Burlinlove/shoggoth-mini/assets/synthetic/objects/1.png

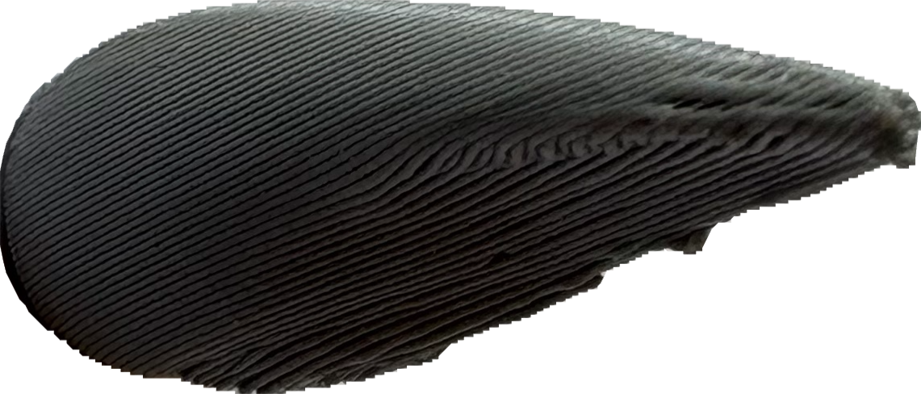
assets/synthetic/objects/1.png
