Burlinlove/shoggoth-mini/assets/synthetic/objects/2.png

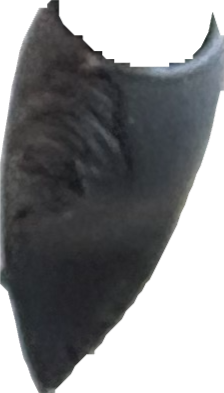
assets/synthetic/objects/2.png
