Burlinlove/shoggoth-mini/assets/synthetic/objects/3.png

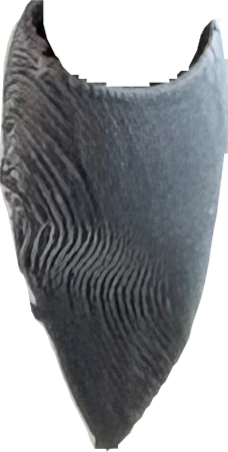
assets/synthetic/objects/3.png
