Burlinlove/shoggoth-mini/assets/synthetic/objects/4.png

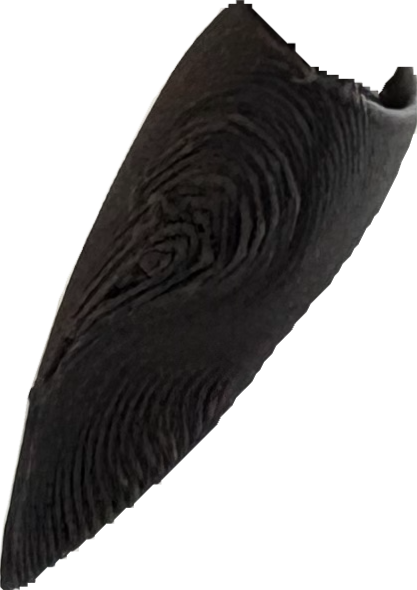
assets/synthetic/objects/4.png
