Burlinlove/shoggoth-mini/assets/synthetic/objects/5.png

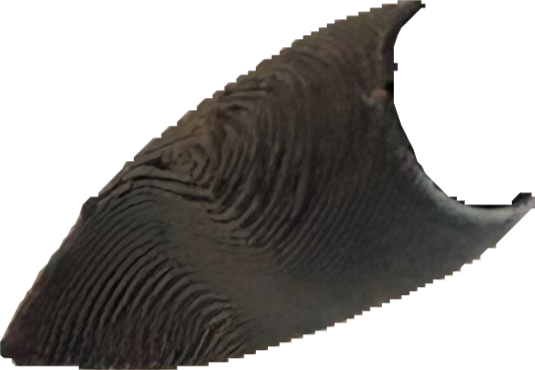
assets/synthetic/objects/5.png
