Burlinlove/shoggoth-mini/assets/synthetic/objects/6.png

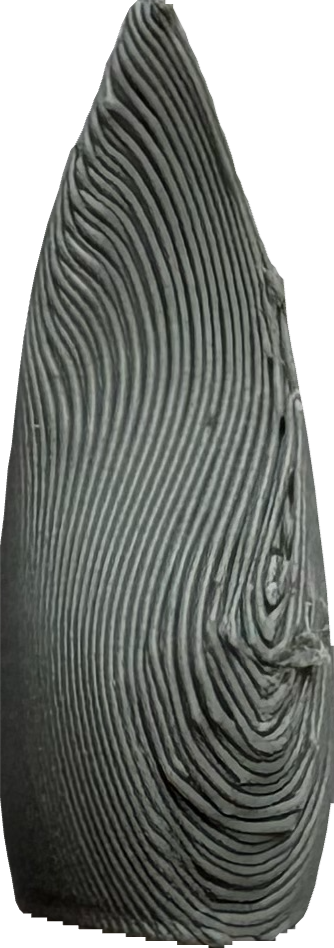
assets/synthetic/objects/6.png
