Burlinlove/shoggoth-mini/assets/synthetic/objects/7.png

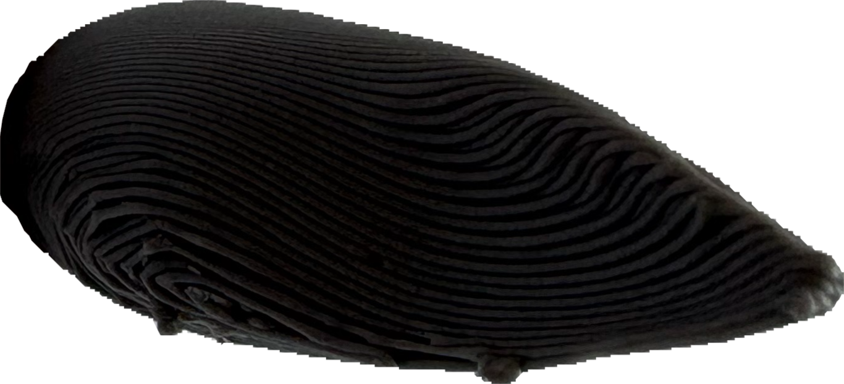
assets/synthetic/objects/7.png
