Burlinlove/shoggoth-mini/assets/synthetic/objects/8.png

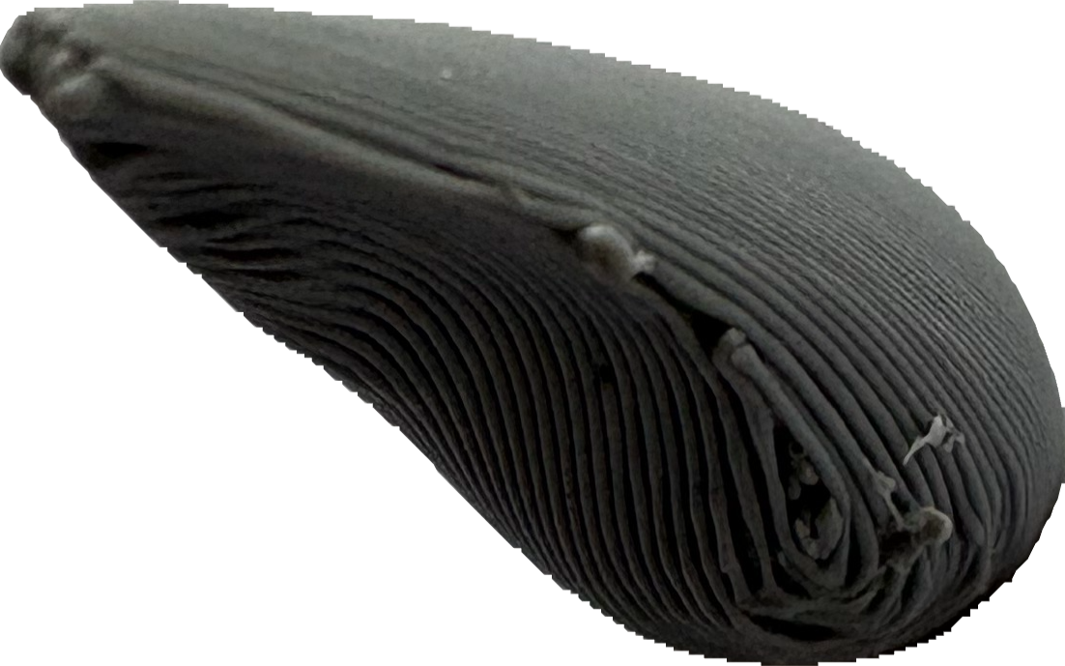
assets/synthetic/objects/8.png
