Burlinlove/shoggoth-mini/assets/synthetic/objects/9.png

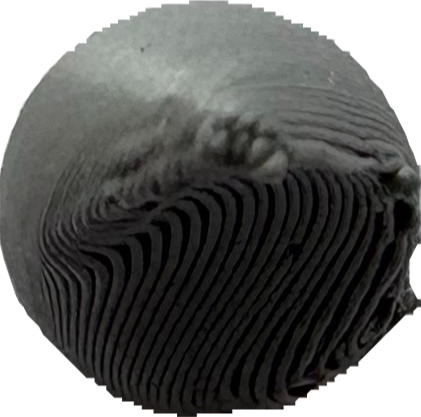
assets/synthetic/objects/9.png
