Burlinlove/shoggoth-mini/assets/synthetic/objects/10.png

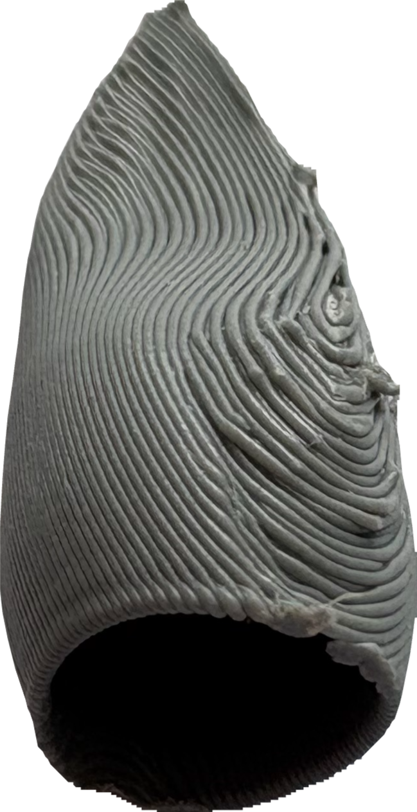
assets/synthetic/objects/10.png
