Burlinlove/shoggoth-mini/assets/synthetic/objects/11.png

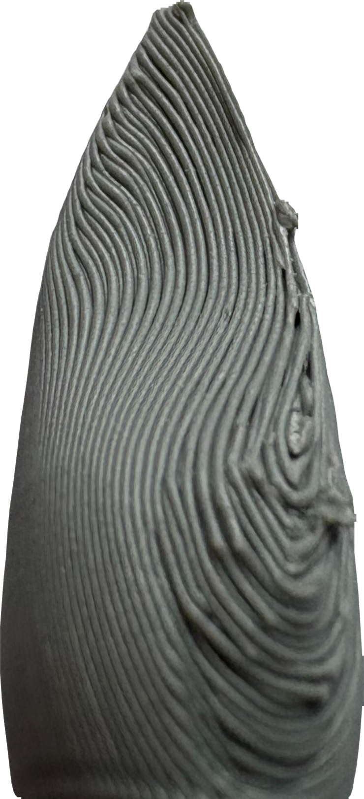
assets/synthetic/objects/11.png
