Burlinlove/shoggoth-mini/assets/synthetic/objects/12.png

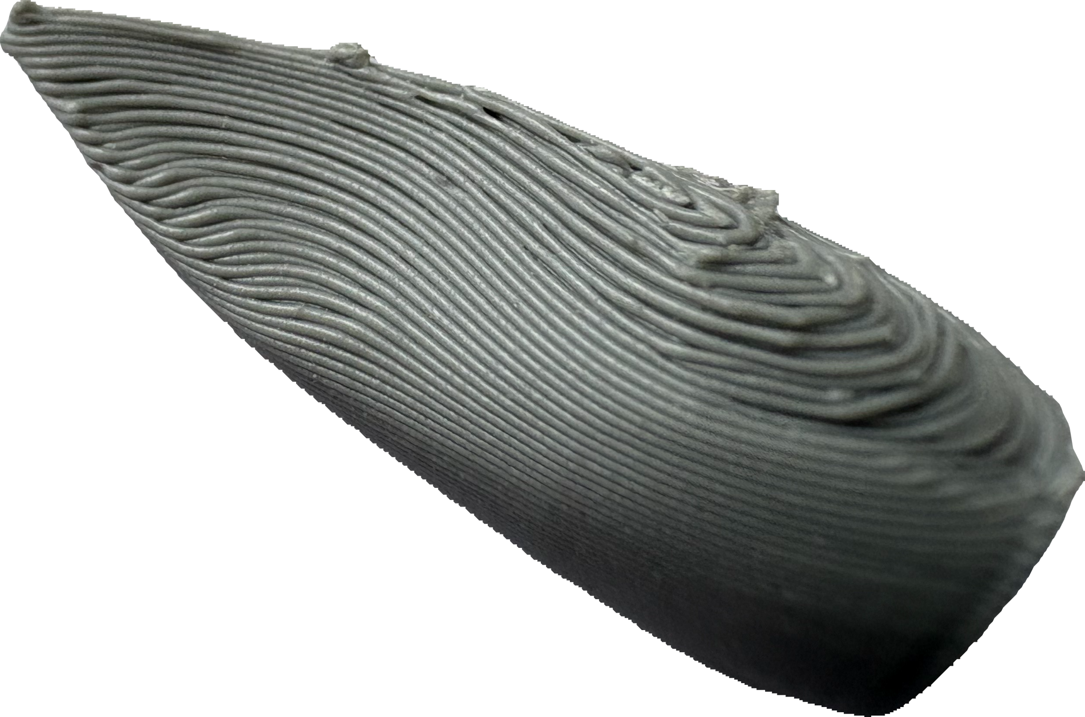
assets/synthetic/objects/12.png
