Burlinlove/shoggoth-mini/assets/synthetic/objects/13.png

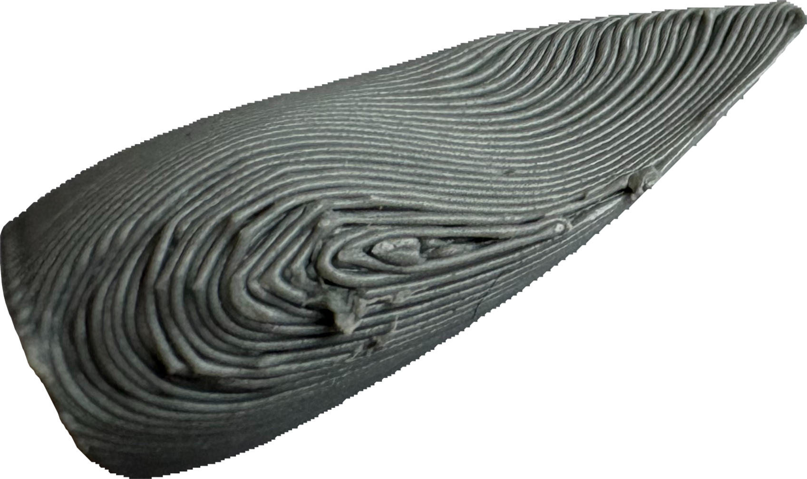
assets/synthetic/objects/13.png
