Burlinlove/shoggoth-mini/assets/hardware/printing/模型文件/dome.step

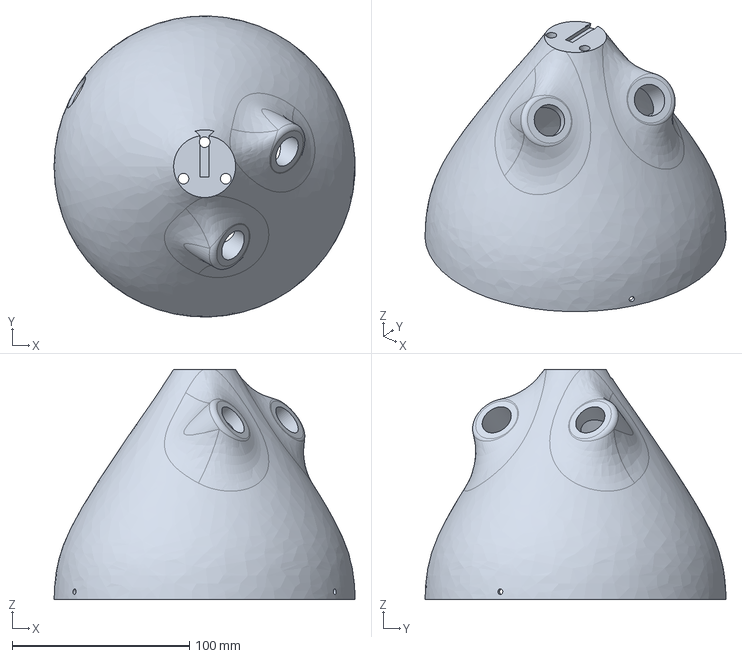
[picture p14: CAD file, 2025-07-18]
assets/hardware/printing/模型文件/dome.step
169.9 x 169.9 x 130.0 mm
