Burlinlove/shoggoth-mini/assets/simulation/mujoco_assets/Part14.stl

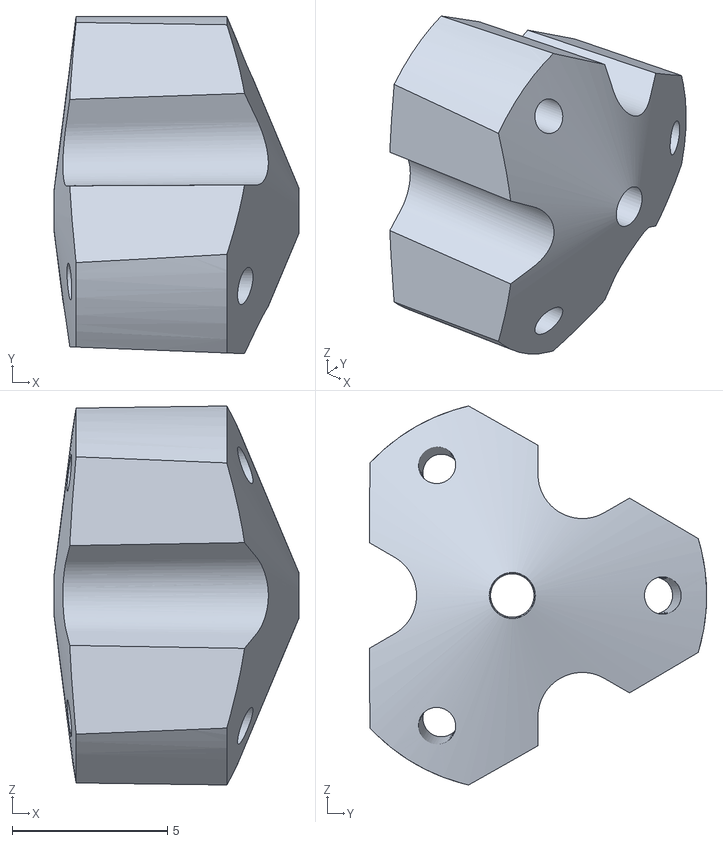
[picture p15: CAD file, 2025-07-02]
assets/simulation/mujoco_assets/Part14.stl
7.88 x 10.9 x 12.2
