Burlinlove/shoggoth-mini/assets/hardware/printing/模型文件/roller_cover.step

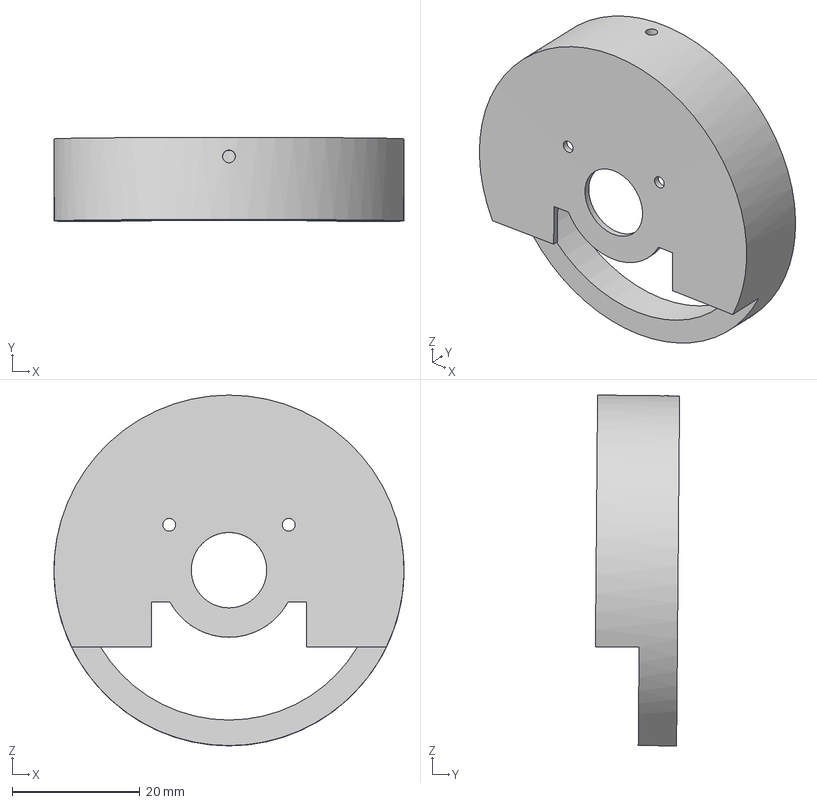
[picture p16: CAD file, 2025-07-02]
assets/hardware/printing/模型文件/roller_cover.step
54.8 x 13.2 x 54.9 mm
