Burlinlove/shoggoth-mini/assets/simulation/mujoco_assets/Part18.stl

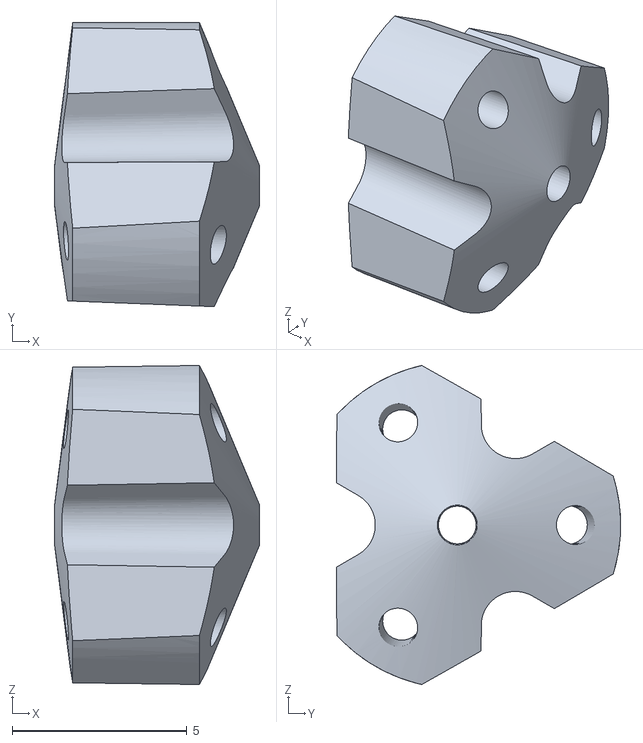
[picture p17: CAD file, 2025-07-02]
assets/simulation/mujoco_assets/Part18.stl
5.87 x 8.13 x 9.12
