Burlinlove/shoggoth-mini/assets/hardware/printing/模型文件/thick_spirobs.3mf

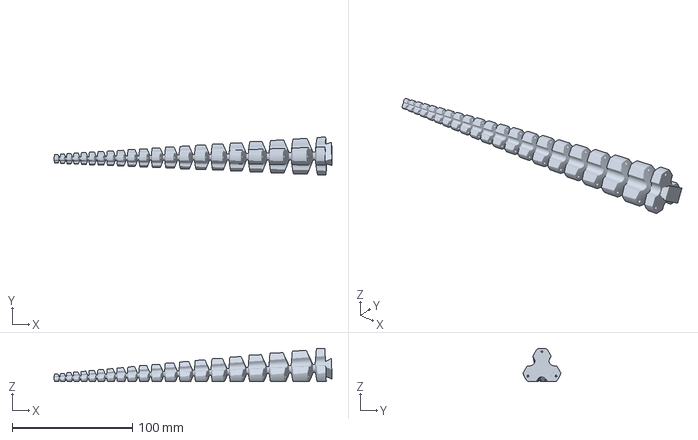
[picture p18: CAD file, 2025-07-02]
assets/hardware/printing/模型文件/thick_spirobs.3mf
231.5 x 31.4 x 27.8 mm
