Burlinlove/shoggoth-mini/assets/simulation/mujoco_assets/Part17.stl

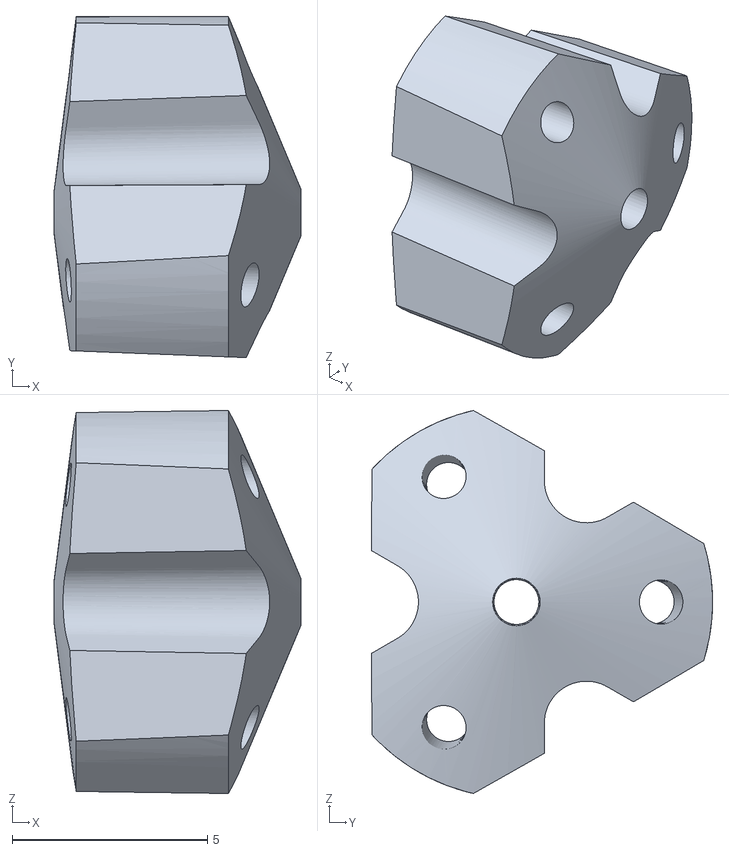
[picture p19: CAD file, 2025-07-02]
assets/simulation/mujoco_assets/Part17.stl
6.32 x 8.74 x 9.81
