Burlinlove/shoggoth-mini/assets/hardware/printing/模型文件/spike.step

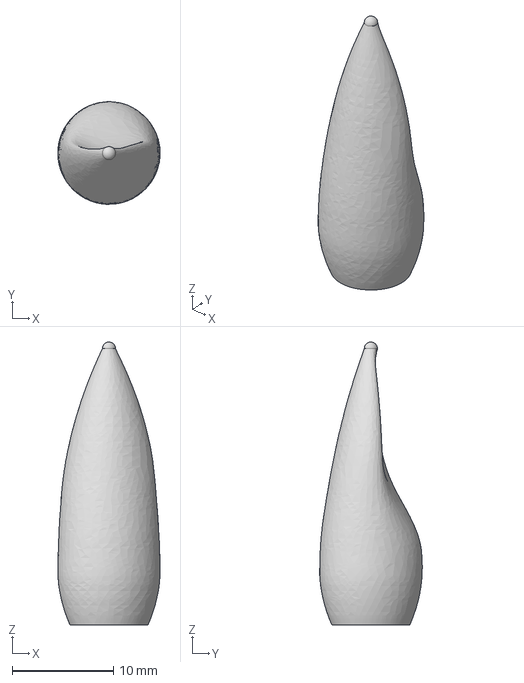
[picture p20: CAD file, 2025-07-02]
assets/hardware/printing/模型文件/spike.step
10.1 x 10.1 x 27.9 mm
