Burlinlove/shoggoth-mini/assets/simulation/mujoco_assets/Part4.stl

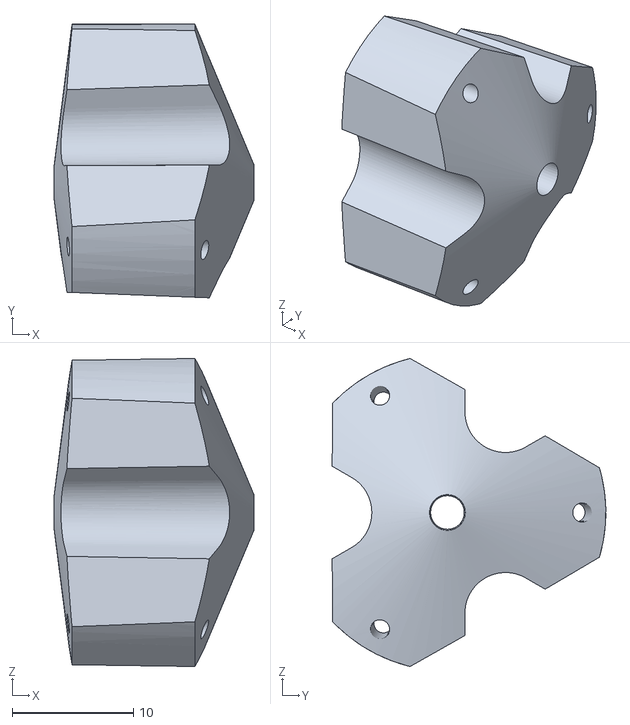
[picture p21: CAD file, 2025-07-02]
assets/simulation/mujoco_assets/Part4.stl
16.4 x 22.5 x 25.4
