Burlinlove/shoggoth-mini/assets/hardware/printing/模型文件/plate.step

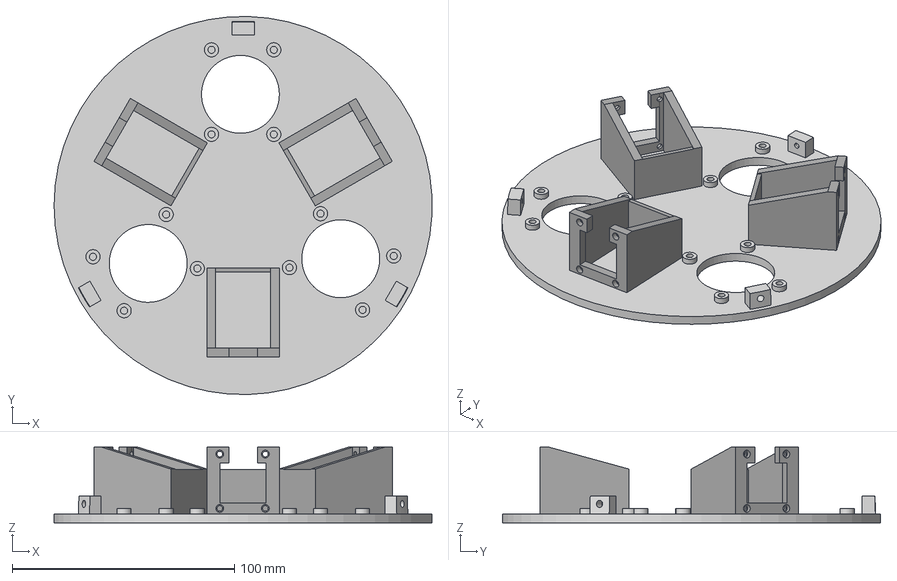
[picture p22: CAD file, 2025-07-02]
assets/hardware/printing/模型文件/plate.step
169.9 x 169.9 x 34.0 mm
