Burlinlove/shoggoth-mini/assets/simulation/mujoco_assets/Part16.stl

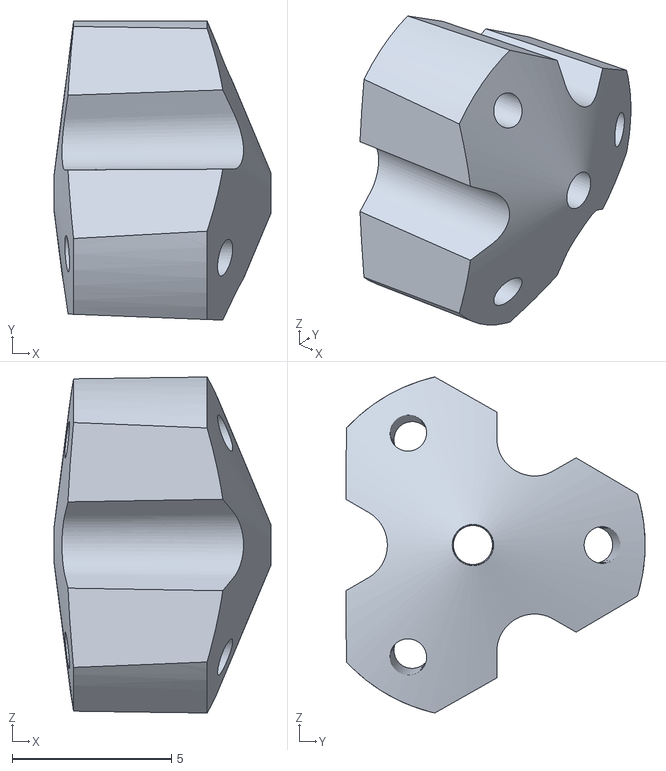
[picture p23: CAD file, 2025-07-02]
assets/simulation/mujoco_assets/Part16.stl
6.80 x 9.40 x 10.6
