Burlinlove/shoggoth-mini/assets/hardware/printing/模型文件/roller.step

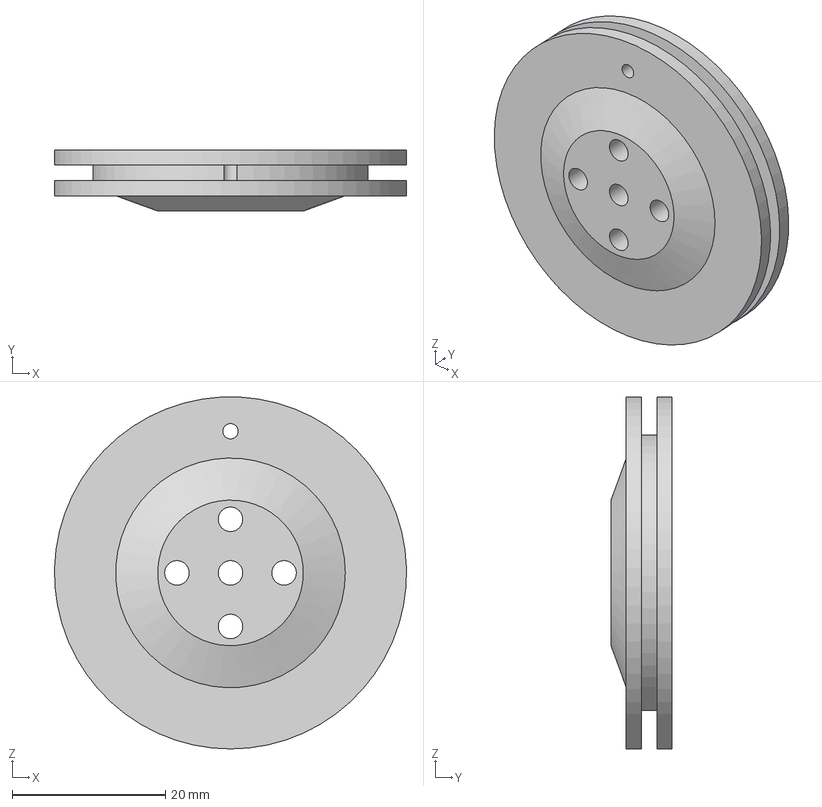
[picture p24: CAD file, 2025-07-02]
assets/hardware/printing/模型文件/roller.step
46.0 x 8.00 x 46.0 mm
