Burlinlove/shoggoth-mini/assets/simulation/mujoco_assets/Part20.stl

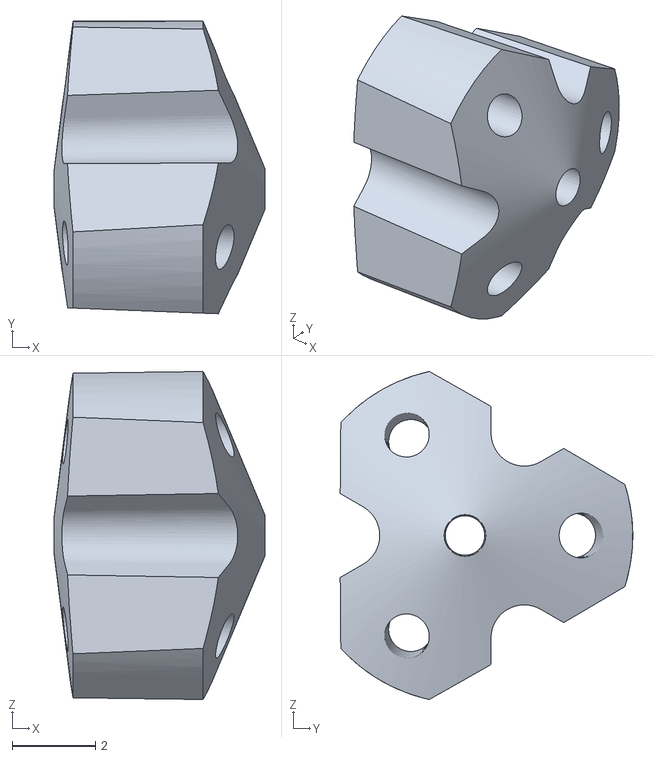
[picture p25: CAD file, 2025-07-02]
assets/simulation/mujoco_assets/Part20.stl
5.06 x 7.04 x 7.89
