Burlinlove/shoggoth-mini/assets/simulation/mujoco_assets/Part2.stl

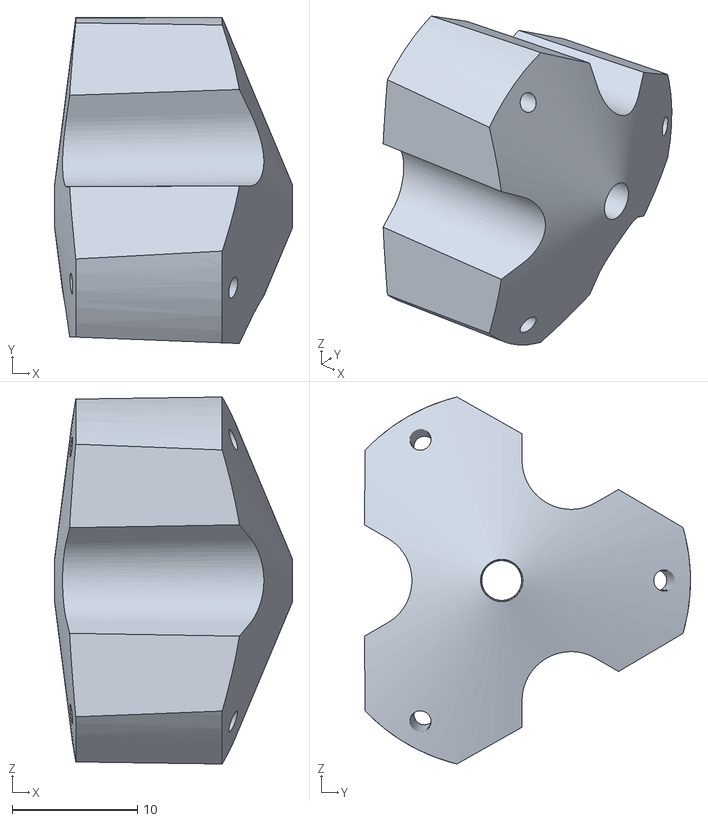
[picture p26: CAD file, 2025-07-02]
assets/simulation/mujoco_assets/Part2.stl
19.1 x 26.1 x 29.3
