Burlinlove/shoggoth-mini/assets/simulation/mujoco_assets/Part10.stl

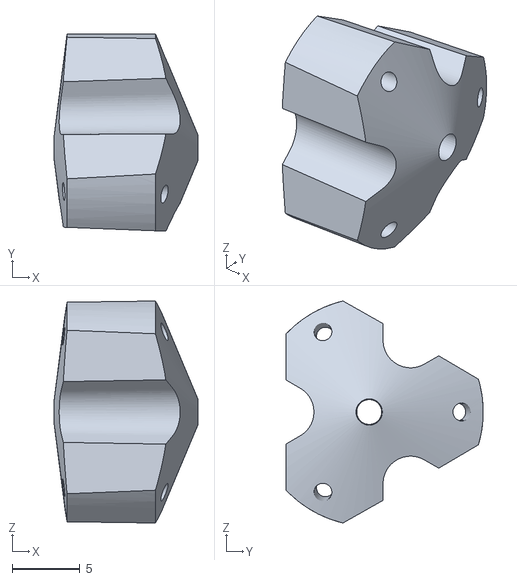
[picture p27: CAD file, 2025-07-02]
assets/simulation/mujoco_assets/Part10.stl
10.6 x 14.5 x 16.4
