Burlinlove/shoggoth-mini/assets/simulation/mujoco_assets/Part15.stl

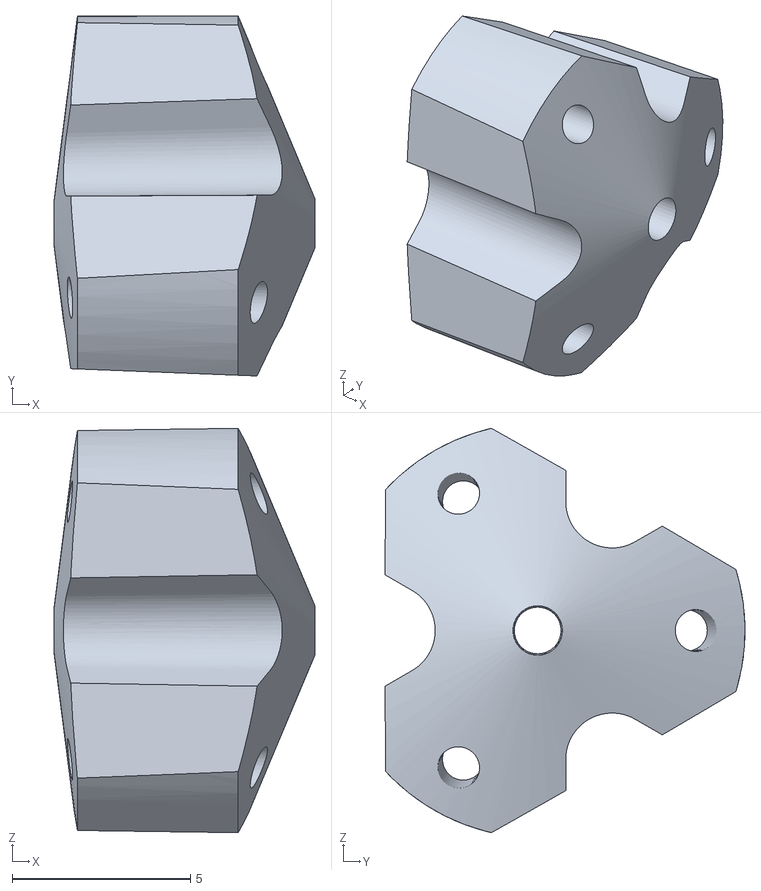
[picture p28: CAD file, 2025-07-02]
assets/simulation/mujoco_assets/Part15.stl
7.32 x 10.1 x 11.4
