Burlinlove/shoggoth-mini/assets/simulation/mujoco_assets/Part11.stl

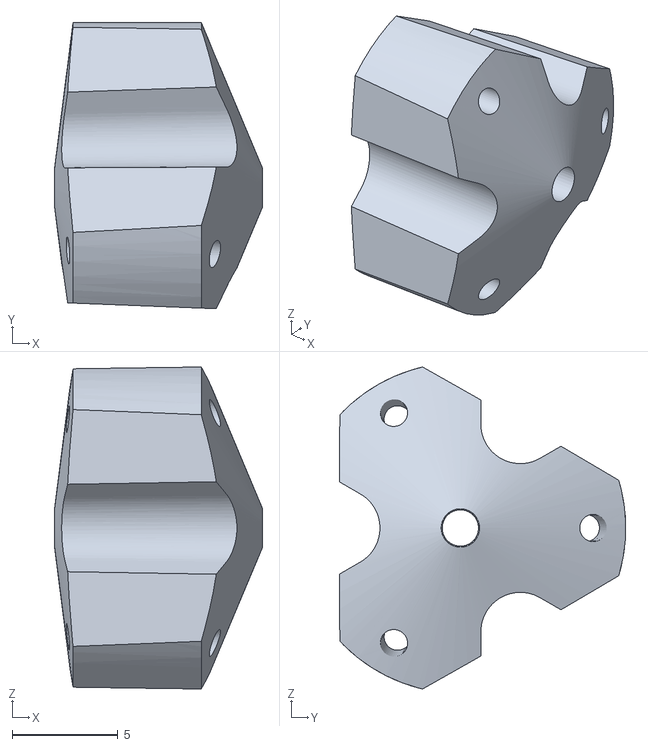
[picture p29: CAD file, 2025-07-02]
assets/simulation/mujoco_assets/Part11.stl
9.83 x 13.5 x 15.2
