Burlinlove/shoggoth-mini/assets/simulation/mujoco_assets/Part8.stl

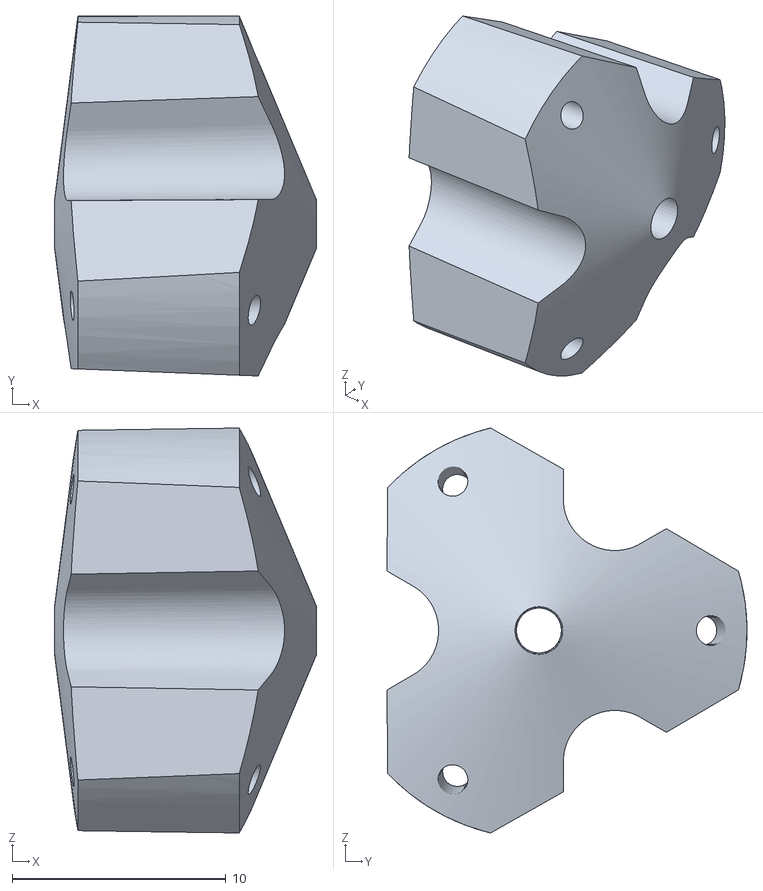
[picture p30: CAD file, 2025-07-02]
assets/simulation/mujoco_assets/Part8.stl
12.3 x 16.8 x 18.9
