Burlinlove/shoggoth-mini/assets/simulation/mujoco_assets/Part12.stl

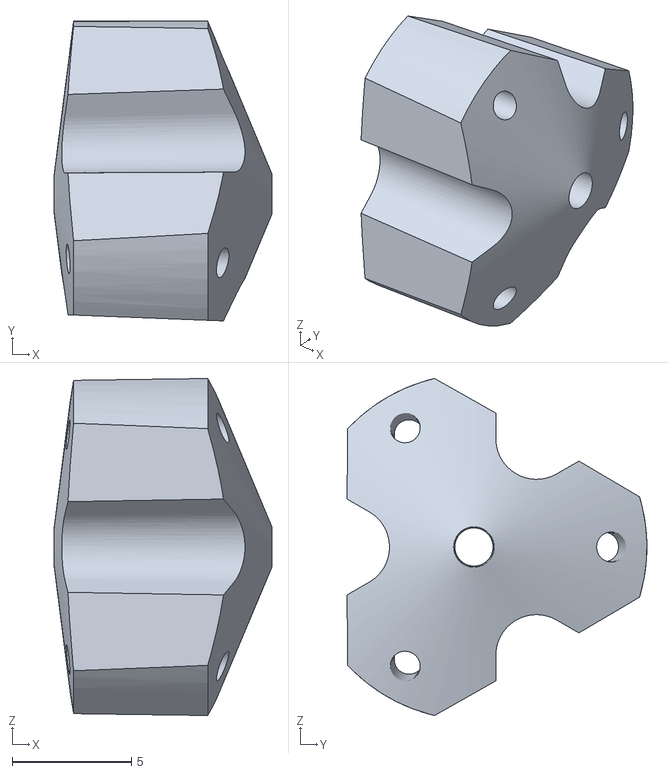
[picture p31: CAD file, 2025-07-02]
assets/simulation/mujoco_assets/Part12.stl
9.13 x 12.6 x 14.1
