Burlinlove/shoggoth-mini/assets/simulation/mujoco_assets/Part9.stl

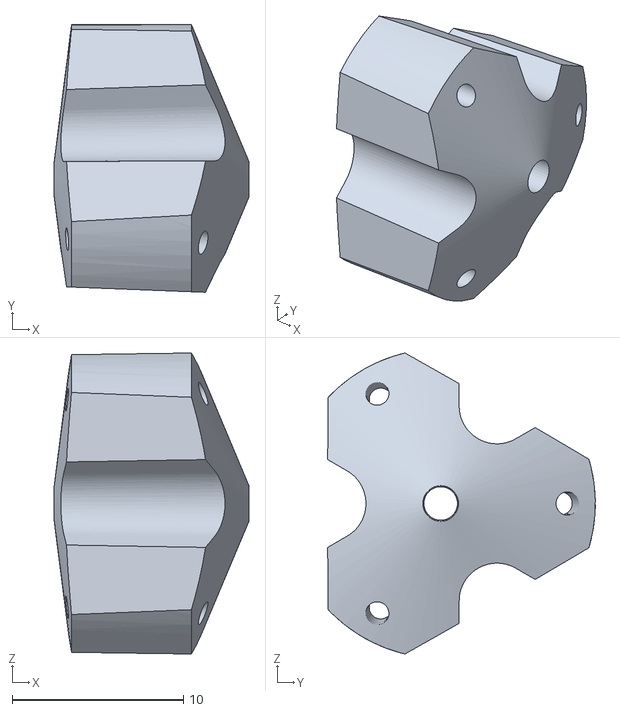
[picture p32: CAD file, 2025-07-02]
assets/simulation/mujoco_assets/Part9.stl
11.4 x 15.6 x 17.6
