Burlinlove/shoggoth-mini/assets/simulation/mujoco_assets/Part13.stl

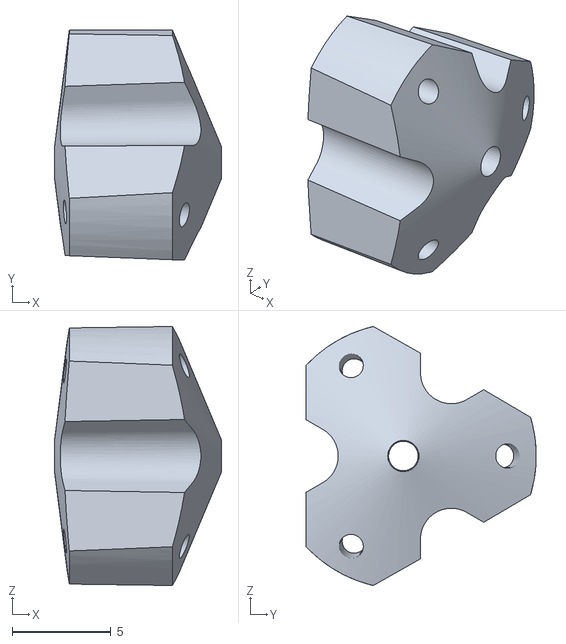
[picture p33: CAD file, 2025-07-02]
assets/simulation/mujoco_assets/Part13.stl
8.49 x 11.7 x 13.1
