Burlinlove/shoggoth-mini/assets/simulation/mujoco_assets/Part5.stl

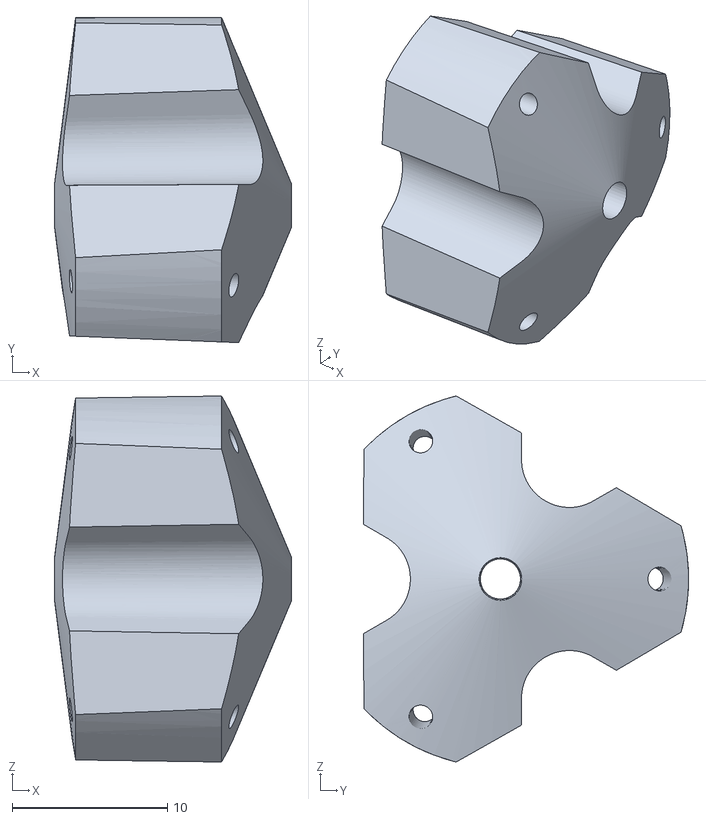
[picture p34: CAD file, 2025-07-02]
assets/simulation/mujoco_assets/Part5.stl
15.3 x 20.9 x 23.6
