Burlinlove/shoggoth-mini/assets/simulation/mujoco_assets/Part21.stl

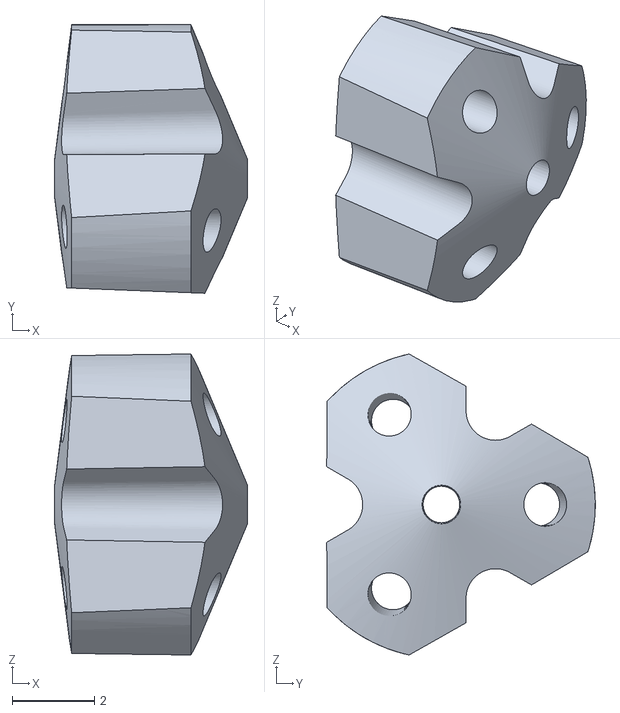
[picture p35: CAD file, 2025-07-02]
assets/simulation/mujoco_assets/Part21.stl
4.70 x 6.55 x 7.33
