Burlinlove/shoggoth-mini/assets/simulation/mujoco_assets/Part6.stl

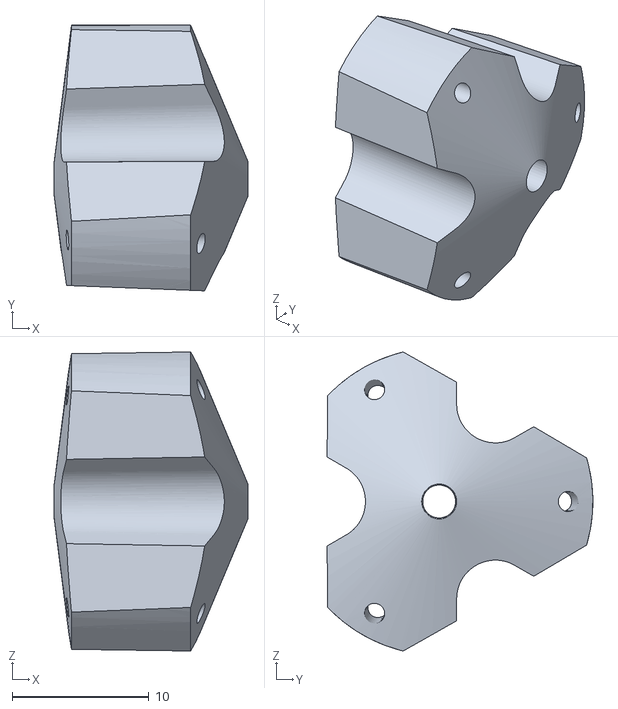
[picture p36: CAD file, 2025-07-02]
assets/simulation/mujoco_assets/Part6.stl
14.2 x 19.5 x 21.9
