Burlinlove/shoggoth-mini/assets/simulation/mujoco_assets/Part19.stl

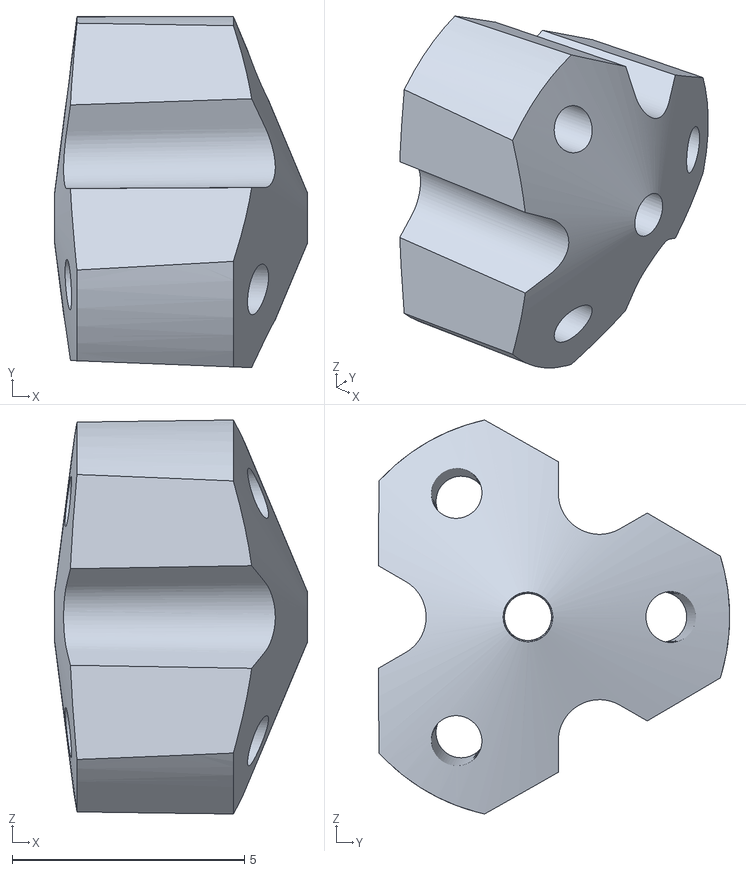
[picture p37: CAD file, 2025-07-02]
assets/simulation/mujoco_assets/Part19.stl
5.45 x 7.56 x 8.48
