Burlinlove/shoggoth-mini/assets/simulation/mujoco_assets/Part1.stl

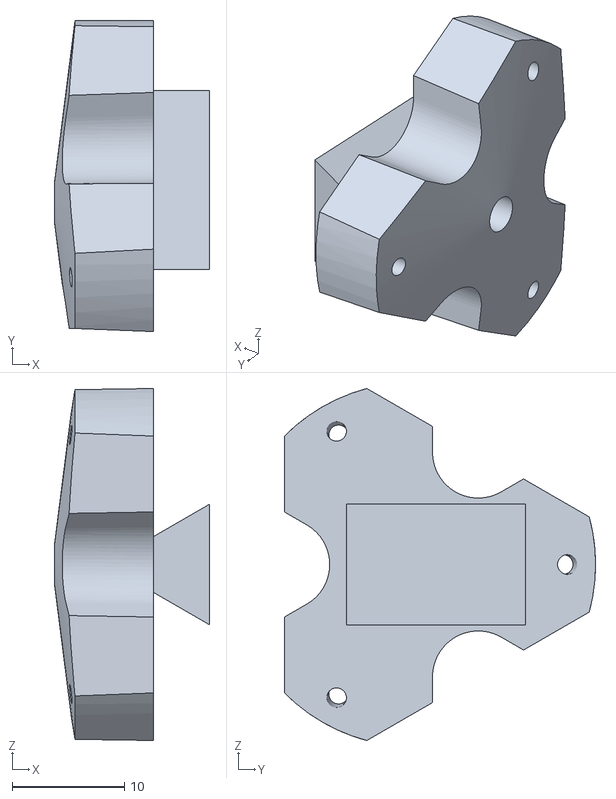
[picture p38: CAD file, 2025-07-02]
assets/simulation/mujoco_assets/Part1.stl
13.9 x 27.8 x 31.4
