Burlinlove/shoggoth-mini/assets/simulation/mujoco_assets/Part3.stl

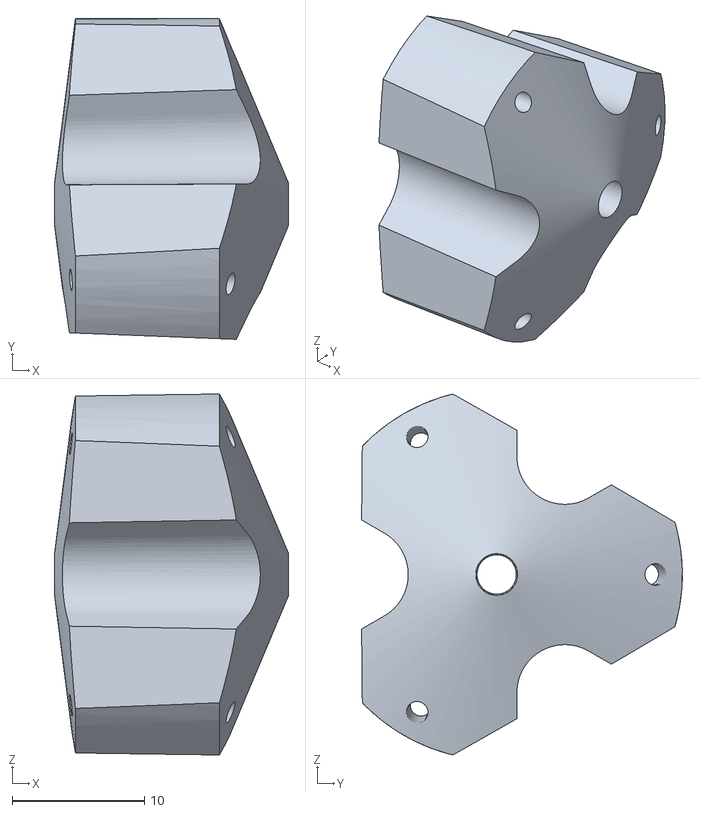
[picture p39: CAD file, 2025-07-02]
assets/simulation/mujoco_assets/Part3.stl
17.7 x 24.2 x 27.3
