Burlinlove/shoggoth-mini/assets/simulation/mujoco_assets/Part7.stl

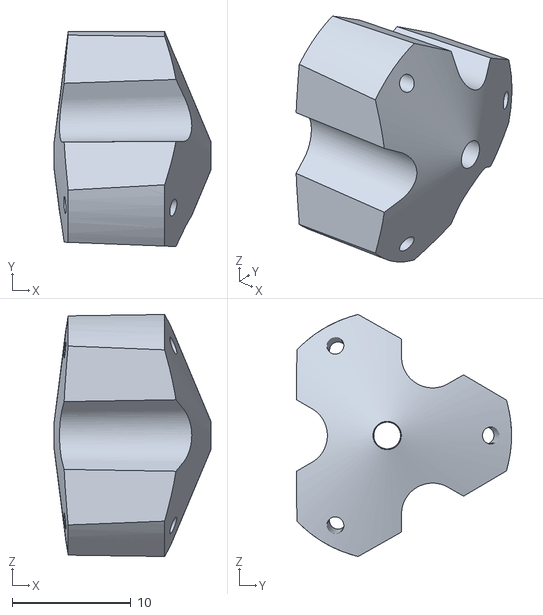
[picture p40: CAD file, 2025-07-02]
assets/simulation/mujoco_assets/Part7.stl
13.2 x 18.1 x 20.4
