Burlinlove/shoggoth-mini/(commit log)

2025-07-18 fix: update dome step file
    [dome.step]
2025-08-24 Update hardware configuration and calibration files
    [default_hardware.yaml]
2025-08-24 Add all new project files and documentation
    - Add Chinese documentation (ASSEMBLY_中文.md, README_中文.md)
    - Add various demo and control scripts
    - Add hardware printing models and configuration
    - Add manual control documentation
    - Add training and testing scripts
    - Add poetry.lock for dependency management
    [dome.step, plate.step, roller.step, roller_cover.step, spike.step, thick_spirobs.3mf]
